Lassehoutenbos/KL-UAS-System/GCS/bottom_panel_developer_overview.docx

Ground Control Station

Bottom Panel — Developer Overview

Firmware Architecture, Hardware Connections & Peripheral Guide

# 1. System Overview

The bottom panel is a hardware input/output module for a ground control station. It collects analog sensor readings, digital switch states, and drives addressable RGB LEDs. All data is aggregated by a Raspberry Pi Pico W microcontroller and forwarded to a Raspberry Pi host computer over USB CDC (virtual serial port). The Pico W runs FreeRTOS, with each peripheral type managed by a dedicated task that feeds a shared queue consumed by the USB transmit task.

The Pico W was chosen for its native USB support, dual-core ARM Cortex-M0+ running at 133 MHz, hardware PIO state machines for precise LED timing, and built-in WiFi/Bluetooth for future OTA firmware updates.

# 2. Hardware Components

## 2.1 Microcontroller — Raspberry Pi Pico W

The central controller. All peripherals connect directly or indirectly to the Pico W.

Feature | Detail
Chip | RP2040 (dual-core ARM Cortex-M0+ @ 133 MHz)
Flash | 2 MB on-board QSPI flash
SRAM | 264 KB
USB | Native USB 1.1 Full Speed (12 Mbps) — CDC via TinyUSB
Wireless | CYW43439 — 2.4 GHz WiFi 802.11n + Bluetooth 5.2 (future OTA)
GPIO | 26 usable GPIO pins
ADC | 4 native 12-bit ADC channels (GP26–GP29)
PIO | 2 PIO blocks, 4 state machines each — used for LED protocols
I2C | 2 hardware I2C controllers
SPI | 2 hardware SPI controllers
Operating voltage | 3.3 V logic, 5 V USB input

## 2.2 GPIO Expander — U1 MCP23017

The MCP23017 is a 16-bit I2C GPIO expander providing additional digital I/O that the Pico W's native pins cannot accommodate. It handles all panel switches and indicator LEDs.

Pin | Connected To | Direction | Description
U1_A0 | LED2 | Output | Indicator LED 2
U1_A1 | LED3 | Output | Indicator LED 3
U1_A2 | LED4 | Output | Indicator LED 4
U1_A5 | KEY | Input | Key switch input
U1_A6 | SW3_3 | Input | Switch 3, contact 3
U1_A7 | SW3_4 | Input | Switch 3, contact 4
U1_B0 | SW1_1 | Input | Switch 1, contact 1
U1_B1 | SW1_2 | Input | Switch 1, contact 2
U1_B2 | SW1_3 | Input | Switch 1, contact 3
U1_B3 | SW2_1 | Input | Switch 2, contact 1
U1_B4 | SW2_2 | Input | Switch 2, contact 2
U1_B5 | SW2_3 | Input | Switch 2, contact 3
U1_B6 | SW3_1 | Input | Switch 3, contact 1
U1_B7 | SW3_2 | Input | Switch 3, contact 2

Connection to Pico W: I2C bus (SDA, SCL). Pull-up resistors required on SDA and SCL lines (4.7 kΩ to 3.3 V). I2C address set by hardware address pins A0–A2 on U1.

## 2.3 SPI ADC — MCP3208

The MCP3208 is an 8-channel 12-bit SPI ADC. It is used to expand the Pico W's 4 native ADC channels to cover all analog inputs on the bottom panel.

Channel | Signal | Description
CH0 | ADC0 BAT VIN | Battery voltage monitor
CH1 | ADC1 EXT VIN | External voltage input monitor
CH2 | SENS2 OUT | Sensor 2 analog output
CH3 | SENS3 OUT | Sensor 3 analog output
CH4 | SENS4 OUT | Sensor 4 analog output
CH5 | SENS5 OUT | Sensor 5 analog output
CH6 | (reserved) | Available for future use
CH7 | (reserved) | Available for future use

Connection to Pico W: SPI bus (SCK, MOSI, MISO, CS). Operates at 3.3 V. Reference voltage sets full-scale range — use 3.3 V VREF for direct compatibility with Pico W logic levels.

## 2.4 SK6812 Addressable LED Chain

The SK6812 addressable RGB LEDs form the primary LED chain on the bottom panel. They are driven by PIO state machine 0 at 800 Kbps using the SK6812 NRZ protocol.

Parameter | Value
Protocol | Single-wire NRZ at 800 Kbps
T0H / T0L | 0.3 µs / 0.9 µs
T1H / T1L | 0.6 µs / 0.6 µs
Reset pulse | > 80 µs low
Color depth | 24-bit RGB (8 bits per channel, GRB order)
Supply voltage | 5 V
Logic level | 5 V data line — requires level shifting from Pico W 3.3 V
Level shifter | U5 — 74LVC1T45DW-7 (3.3 V → 5 V, single direction)
PIO assignment | PIO block 0, state machine 0 (SM0)

## 2.5 WS2811 RGB Button Driver — LED5 & LED6

The two PB-26 RGB illuminated push buttons (LED5 and LED6) are driven by discrete WS2811 driver ICs. The WS2811 is a standalone 3-channel constant-current RGB LED driver in an SOP-8 package. Unlike the SK6812, the WS2811 exposes separate OUTR, OUTG, and OUTB pins which connect directly to the button's R, G, and B LED channels.

The WS2811 uses a different timing spec to the SK6812 (400 Kbps vs 800 Kbps) and therefore cannot share the same PIO data line. A separate PIO state machine is used.

Parameter | Value
Protocol | Single-wire NRZ at 400 Kbps
T0H / T0L | 0.5 µs / 2.0 µs
T1H / T1L | 1.2 µs / 1.3 µs
Reset pulse | > 50 µs low
Color depth | 24-bit RGB (8 bits per channel, RGB order)
Supply voltage | 5 V
Logic level | 5 V data line — requires level shifting from Pico W 3.3 V
Level shifter | Separate 74LVC1T45 (3.3 V → 5 V)
Package | SOP-8
Outputs | OUTR, OUTG, OUTB — connect directly to button LED R/G/B pins
PIO assignment | PIO block 0, state machine 1 (SM1)
Chain | LED5 WS2811 DIN → LED5 WS2811 DOUT → LED6 WS2811 DIN

## 2.6 RGB Buttons — PB-26 (LED5, LED6)

Signal | Wire Color | Connects To | Description
GND (Switch) | Black | GND | Ground for switch circuit
NO (Switch) | White | SW3– / MCP23017 | Normally open contact — read via U1
RGB +5V | Red | +5V rail | Power for RGB LED inside button
RGB R | Yellow | WS2811 OUTR | Red LED channel
RGB G | Green | WS2811 OUTG | Green LED channel
RGB B | Blue | WS2811 OUTB | Blue LED channel

# 3. Bus Connections

## 3.1 I2C Bus

One I2C bus shared between U1 (MCP23017). SDA and SCL lines run from the Pico W to U1. Pull-up resistors (4.7 kΩ) to 3.3 V are required on both lines. The MCP23017 hardware address (A0–A2 pins) must be set in firmware to match the PCB configuration.

Signal | Pico W Pin | Peripheral | Notes
SDA | GP4 (or GP8/GP12/GP16/GP20) | U1 MCP23017 SDA | 4.7 kΩ pull-up to 3.3 V
SCL | GP5 (or GP9/GP13/GP17/GP21) | U1 MCP23017 SCL | 4.7 kΩ pull-up to 3.3 V

## 3.2 SPI Bus

One SPI bus connecting the Pico W to the MCP3208 ADC. Standard 4-wire SPI: SCK, MOSI, MISO, and a dedicated chip select (CS) pin.

Signal | Pico W Pin | Peripheral | Notes
SCK | GP18 (SPI0 SCK) | MCP3208 CLK | SPI clock
MOSI | GP19 (SPI0 TX) | MCP3208 DIN | Data to ADC
MISO | GP16 (SPI0 RX) | MCP3208 DOUT | Data from ADC
CS | GP17 (GPIO) | MCP3208 /CS | Active low chip select

## 3.3 PIO — SK6812 LED Chain (SM0)

Signal | Pico W Pin | Peripheral | Notes
DATA | GP0 (PIO0 SM0) | 74LVC1T45 A pin | 3.3 V output to level shifter input
DATA (shifted) | 74LVC1T45 B pin | SK6812 chain DIN | 5 V shifted output to first LED

## 3.4 PIO — WS2811 Chain (SM1)

Signal | Pico W Pin | Peripheral | Notes
DATA | GP1 (PIO0 SM1) | 74LVC1T45 A pin | 3.3 V output to level shifter input
DATA (shifted) | 74LVC1T45 B pin | LED5 WS2811 DIN | 5 V shifted output
DOUT → DIN | WS2811 (LED5) DOUT | LED6 WS2811 DIN | Chain: LED5 output feeds LED6 input

## 3.5 USB CDC

The Pico W connects to the Raspberry Pi host via its native USB port. The TinyUSB stack running under FreeRTOS exposes a CDC class device. The Raspberry Pi sees the Pico W as /dev/ttyACM0 with no additional drivers required.

# 4. Firmware Architecture

## 4.1 RTOS

The firmware runs FreeRTOS on the RP2040. Each peripheral is managed by a dedicated FreeRTOS task. Tasks communicate via a shared FreeRTOS queue. The USB CDC transmit task is the sole consumer of this queue and serialises all data to the host.

## 4.2 Task Overview

Task | Priority | Period | Responsibility
ADC task | 2 | 10 ms | Reads MCP3208 over SPI. Samples all 6 active channels. Pushes readings to queue.
Digital I/O task | 2 | 20 ms | Reads U1 MCP23017 over I2C. Reports switch states and KEY input.
SK6812 LED task | 1 | On command | Receives LED color commands from queue or internal state. Writes to PIO SM0.
WS2811 LED task | 1 | On command | Controls LED5 and LED6 RGB buttons via PIO SM1 and WS2811 chain.
USB CDC task | 3 | 1 ms | Drains sensor data queue. Serialises to protocol packets. Writes to TinyUSB CDC.
TinyUSB task | 4 (highest) | 1 ms | Calls tud_task() — must run regularly to service USB hardware.

## 4.3 Data Flow

1. ADC task samples MCP3208 every 10 ms and pushes a structured sensor_data_t packet onto the FreeRTOS queue.

2. Digital I/O task polls the MCP23017 every 20 ms and pushes a digital_state_t packet onto the same queue.

3. USB CDC task wakes every 1 ms, drains the queue, serialises each packet using the binary protocol (see Section 5), and writes to the TinyUSB CDC TX buffer.

4. TinyUSB task flushes the CDC TX buffer to the USB hardware. On the host, the Raspberry Pi reads /dev/ttyACM0 using pyserial or equivalent.

5. LED tasks run independently. They receive color update commands from the USB CDC RX path (host → Pico W) or from internal logic, and update the LED chains via the respective PIO state machine.

## 4.4 PIO Programs

Two PIO programs are loaded at startup, one per state machine:

- sk6812.pio — loaded into PIO0 SM0. Implements 800 Kbps NRZ timing for the SK6812 LED chain. Reads 24-bit GRB pixel data from the TX FIFO and drives the DATA pin.
- ws2811.pio — loaded into PIO0 SM1. Implements 400 Kbps NRZ timing for the WS2811 chain driving LED5 and LED6. Reads 24-bit RGB pixel data from the TX FIFO.

Both PIO programs use DMA to transfer pixel buffers from SRAM to the PIO TX FIFO without CPU involvement, freeing the FreeRTOS scheduler for other tasks.

# 5. USB CDC Data Protocol

## 5.1 Packet Structure

All data over USB CDC uses a simple binary framing protocol. Each packet has a fixed header followed by a variable payload.

Byte(s) | Field | Value / Description
0 | Start byte | 0xAA — fixed frame delimiter
1 | Packet type | 0x01 = ADC data, 0x02 = Digital I/O, 0x03 = LED command (host → Pico)
2 | Payload length | Number of payload bytes that follow (0–255)
3..N | Payload | Type-specific data (see below)
N+1 | Checksum | XOR of all payload bytes

## 5.2 Packet Types

### Type 0x01 — ADC Data (Pico W → Raspberry Pi)

Offset | Field | Type | Description
0–1 | ch0_bat_vin | uint16_t | Battery voltage raw ADC count (0–4095)
2–3 | ch1_ext_vin | uint16_t | External voltage raw ADC count
4–5 | ch2_sens2 | uint16_t | Sensor 2 raw ADC count
6–7 | ch3_sens3 | uint16_t | Sensor 3 raw ADC count
8–9 | ch4_sens4 | uint16_t | Sensor 4 raw ADC count
10–11 | ch5_sens5 | uint16_t | Sensor 5 raw ADC count
12–13 | timestamp_ms | uint16_t | FreeRTOS tick count (ms) at sample time

### Type 0x02 — Digital I/O State (Pico W → Raspberry Pi)

Offset | Field | Type | Description
0 | port_a | uint8_t | MCP23017 port A state (bits 0–7 = A0–A7)
1 | port_b | uint8_t | MCP23017 port B state (bits 0–7 = B0–B7)
2–3 | timestamp_ms | uint16_t | FreeRTOS tick count (ms)

### Type 0x03 — LED Command (Raspberry Pi → Pico W)

Offset | Field | Type | Description
0 | chain | uint8_t | 0x00 = SK6812 chain, 0x01 = WS2811 chain (LED5+6)
1 | num_pixels | uint8_t | Number of pixels in this update
2..N | pixel_data | uint8_t[] | GRB bytes for SK6812, RGB bytes for WS2811. 3 bytes per pixel.

# 6. Source File Structure

File | Responsibility
src/main.c | FreeRTOS scheduler init. Creates all tasks. Initialises hardware (I2C, SPI, PIO, USB).
src/usb_cdc.c/h | TinyUSB CDC task. Packet serialisation/deserialisation. TX queue consumer.
src/protocol.c/h | Packet struct definitions. Serialise/deserialise helpers. Checksum.
src/analog.c/h | ADC task. MCP3208 SPI driver. Reads all 6 channels, pushes sensor_data_t to queue.
src/digital_io.c/h | Digital I/O task. MCP23017 I2C driver. Reads port A and B, pushes digital_state_t.
src/led_sk6812.c/h | SK6812 LED task. Manages pixel buffer. Triggers DMA transfer to PIO0 SM0.
src/led_ws2811.c/h | WS2811 LED task. Manages LED5 and LED6 pixel state. DMA to PIO0 SM1.
src/sk6812.pio | PIO assembly program for SK6812 — 800 Kbps NRZ timing.
src/ws2811.pio | PIO assembly program for WS2811 — 400 Kbps NRZ timing.
tusb_config.h | TinyUSB configuration. CDC class enabled. FreeRTOS mode.
FreeRTOSConfig.h | FreeRTOS kernel configuration. Heap size, tick rate, task priorities.
CMakeLists.txt | Build system. Links SDK, FreeRTOS, TinyUSB, PIO header generation.

# 7. Development Notes

- All GPIO pin numbers above are suggestions. Final pin assignment must be confirmed against the PCB layout and locked in a single header file (e.g. pins.h).
- The FreeRTOS heap is set to 192 KB. Monitor stack usage during development with uxTaskGetStackHighWaterMark().
- The WS2811 expects RGB byte order. The SK6812 expects GRB byte order. Ensure the correct order is used in each LED task's pixel buffer.
- The MCP23017 interrupt pins (INTA, INTB) are available but not used in the initial design. Consider enabling interrupt-driven I/O reading instead of polling to reduce I2C bus load.
- The CYW43439 WiFi chip shares the SPI bus with the RP2040 internally. The Pico W SDK manages this — do not use SPI1 pins that conflict with the wireless chip. Check the Pico W pinout before assigning SPI1.
- For OTA firmware updates, the pico_cyw43_arch_lwip_sys_freertos library is already linked in CMakeLists.txt. A future WiFi task can be added without restructuring the existing architecture.
- The 74LVC1T45 level shifters require the direction pin (DIR) to be tied to VCC or GND permanently for a single direction. Confirm direction pin wiring on the PCB matches firmware expectations.

Confidential — Internal Use OnlyPage

Ground Control Station — Bottom Panel Developer Overview
