Lassehoutenbos/KL-UAS-System/GCS/docs/Schematic_Flightcase_2026-04-02.png

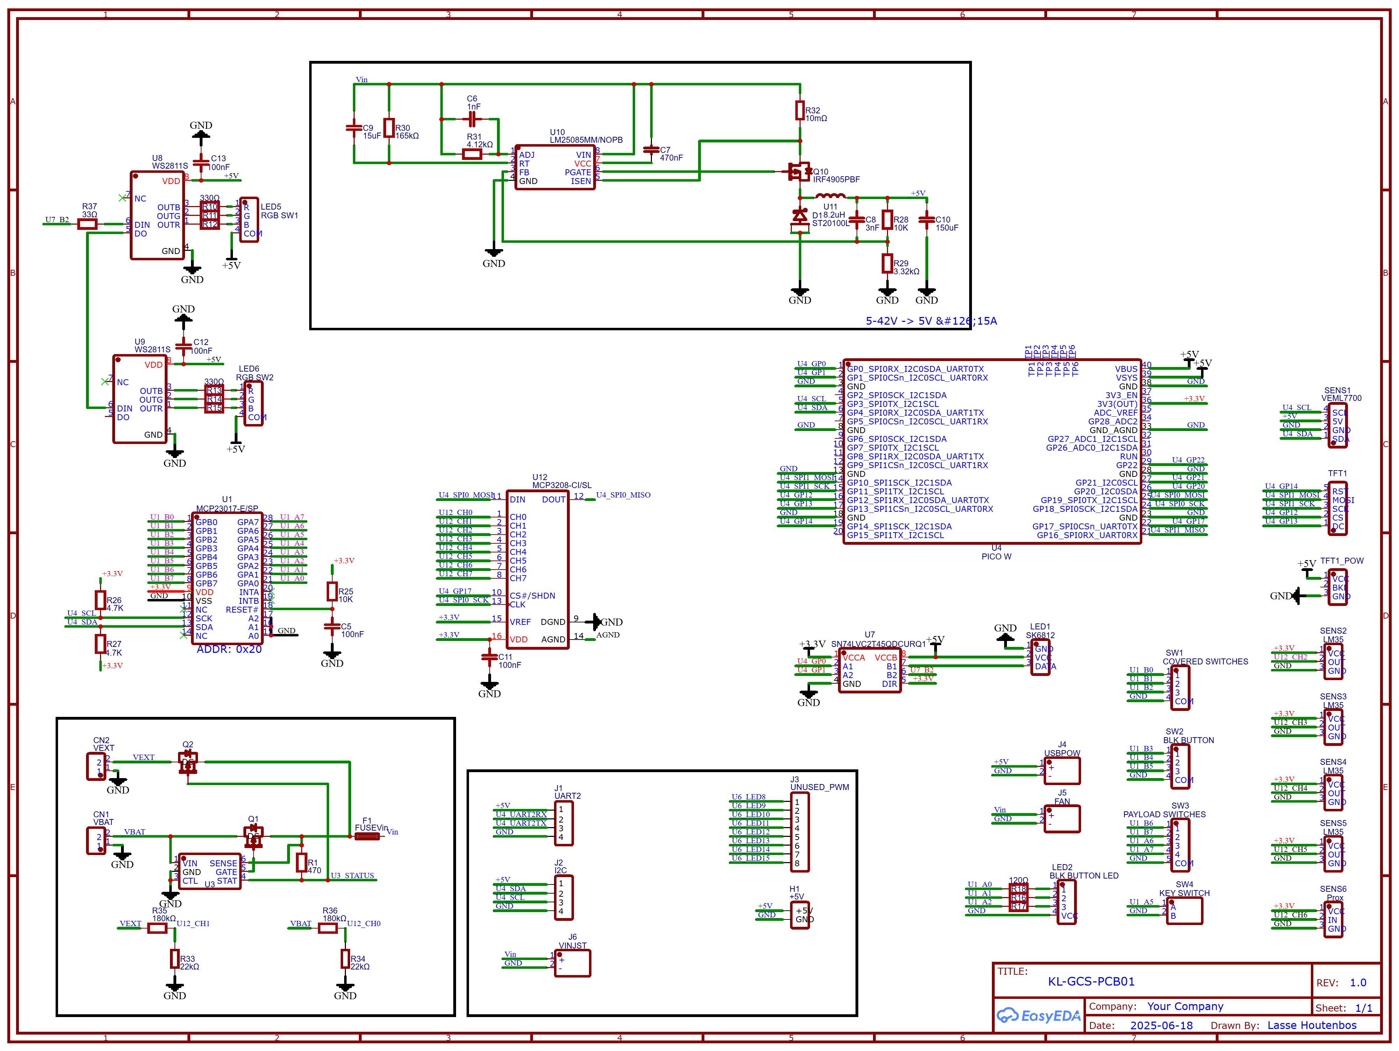
GCS/docs/Schematic_Flightcase_2026-04-02.png
