Lassehoutenbos/KL-UAS-System/KL-GCS-PICODE/PICODE/Schermafbeelding 2026-04-06 224630.png

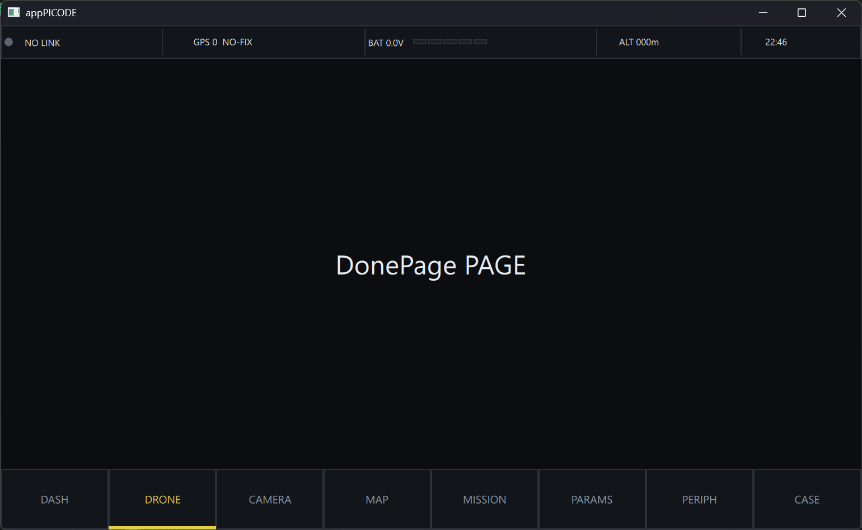
KL-GCS-PICODE/PICODE/Schermafbeelding 2026-04-06 224630.png
