Lassehoutenbos/KL-UAS-System/PCBCodeDocs/images.jpg

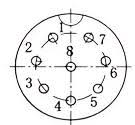
PCBCodeDocs/images.jpg
