Lassehoutenbos/KL-UAS-System/Sticker/Case v10.png

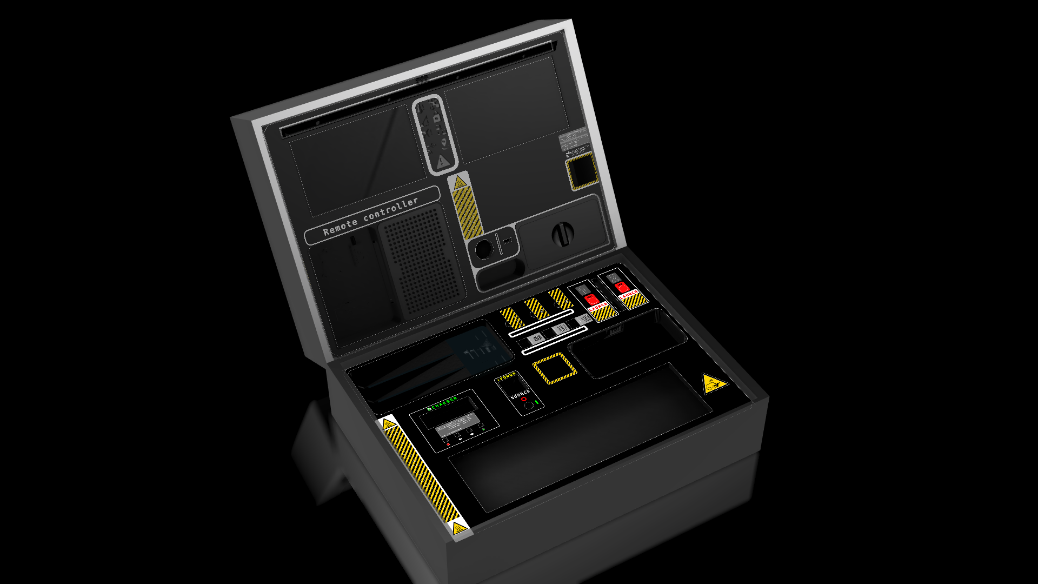
Sticker/Case v10.png
