Lassehoutenbos/KL-UAS-System/Sticker/Case_2026-Apr-13_04-44-15PM-000_CustomizedView62918959768_png_alpha.png

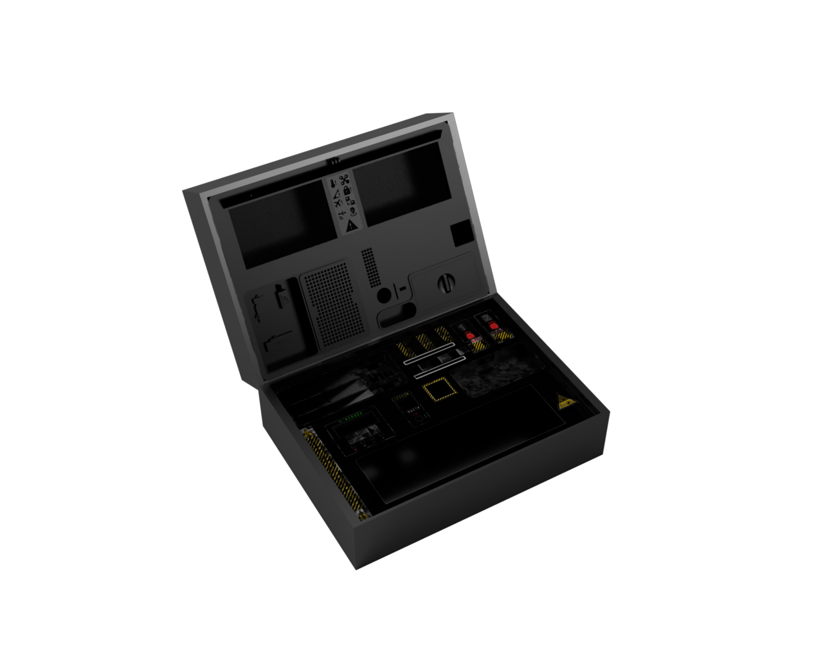
Sticker/Case_2026-Apr-13_04-44-15PM-000_CustomizedView62918959768_png_alpha.png
