Lassehoutenbos/KL-UAS-System/Sticker/Exports/bitmap.png

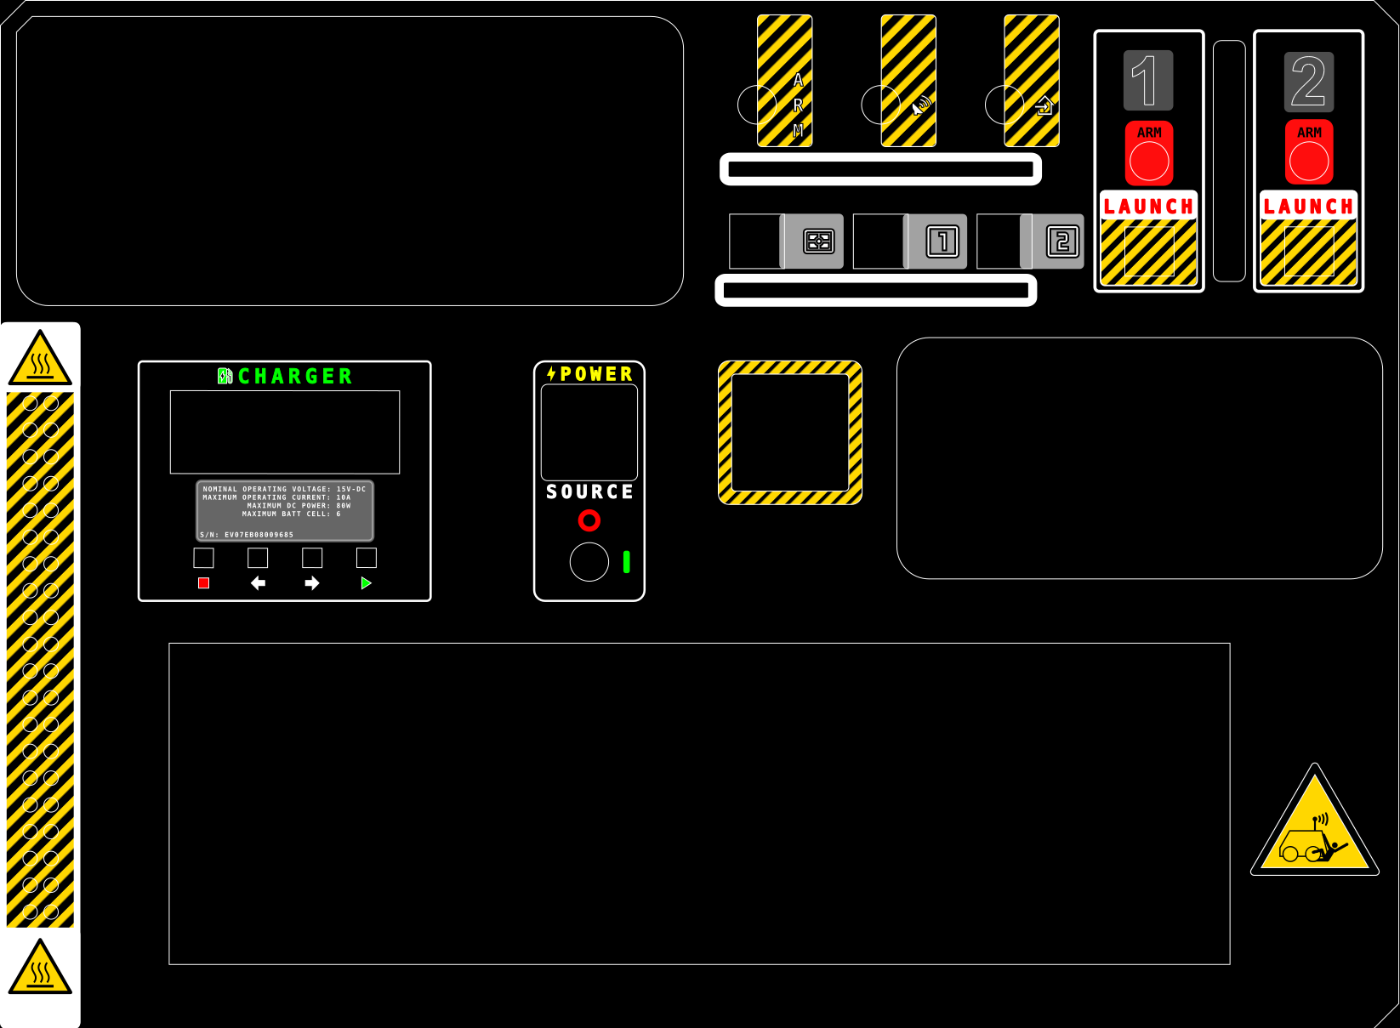
Sticker/Exports/bitmap.png
