Lassehoutenbos/KL-UAS-System/Sticker/Exports/forrender.png

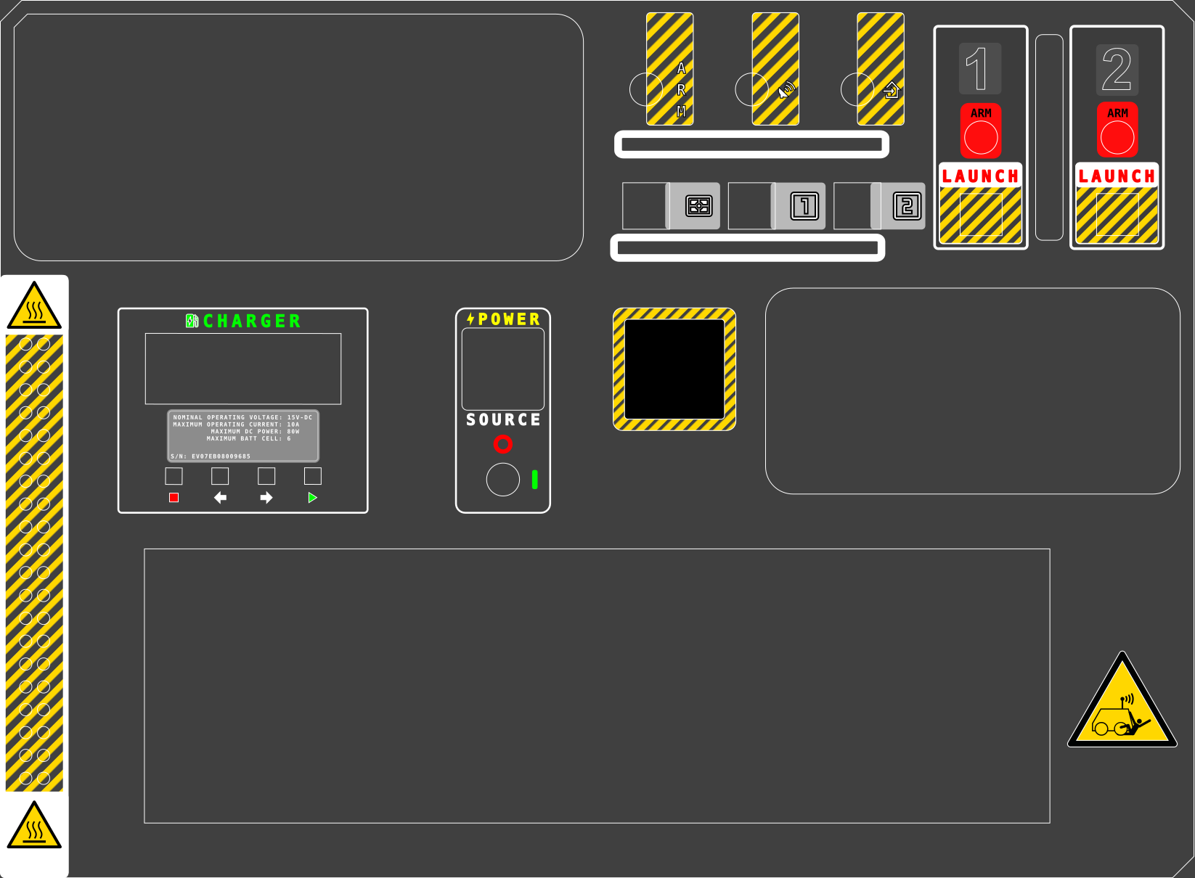
Sticker/Exports/forrender.png
