Lassehoutenbos/KL-UAS-System/Sticker/Exports/forrender_flipped.png

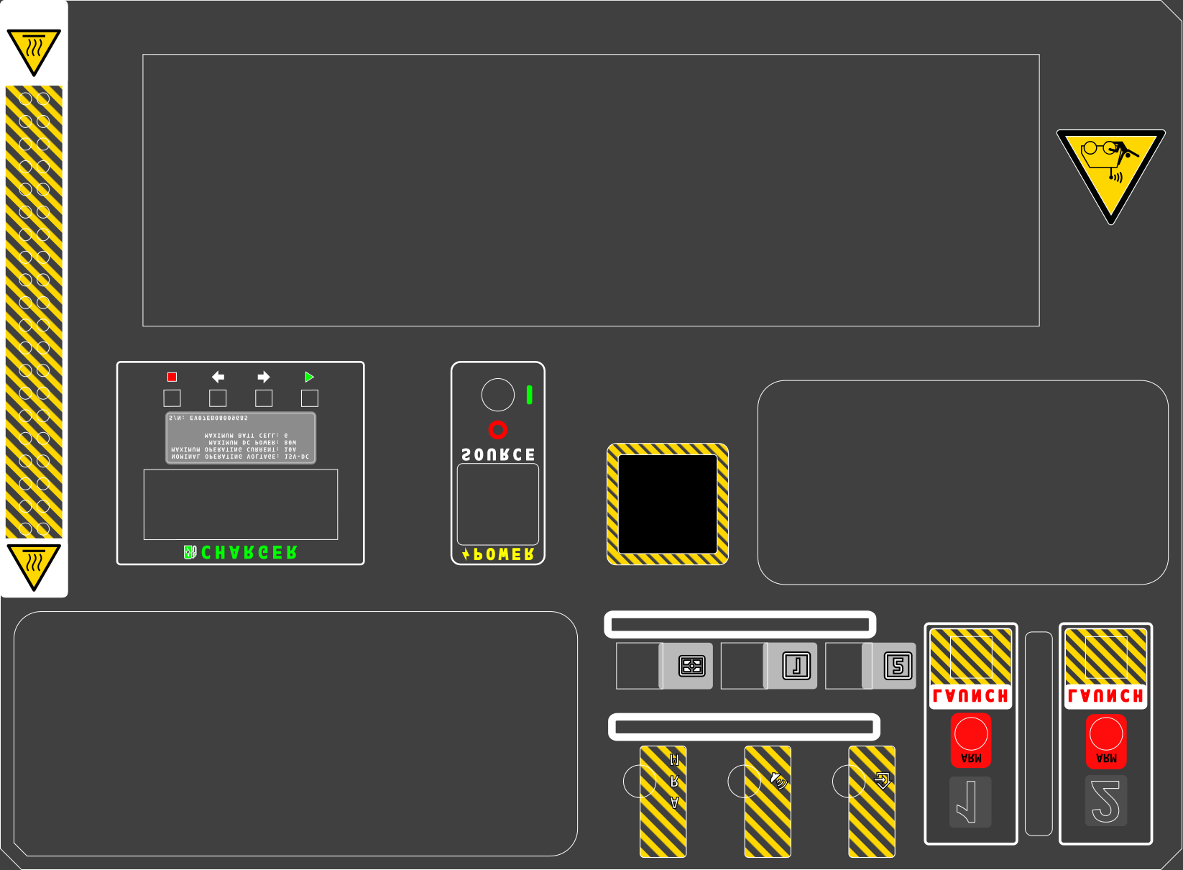
Sticker/Exports/forrender_flipped.png
