Lassehoutenbos/KL-UAS-System/Sticker/TopPanel.png

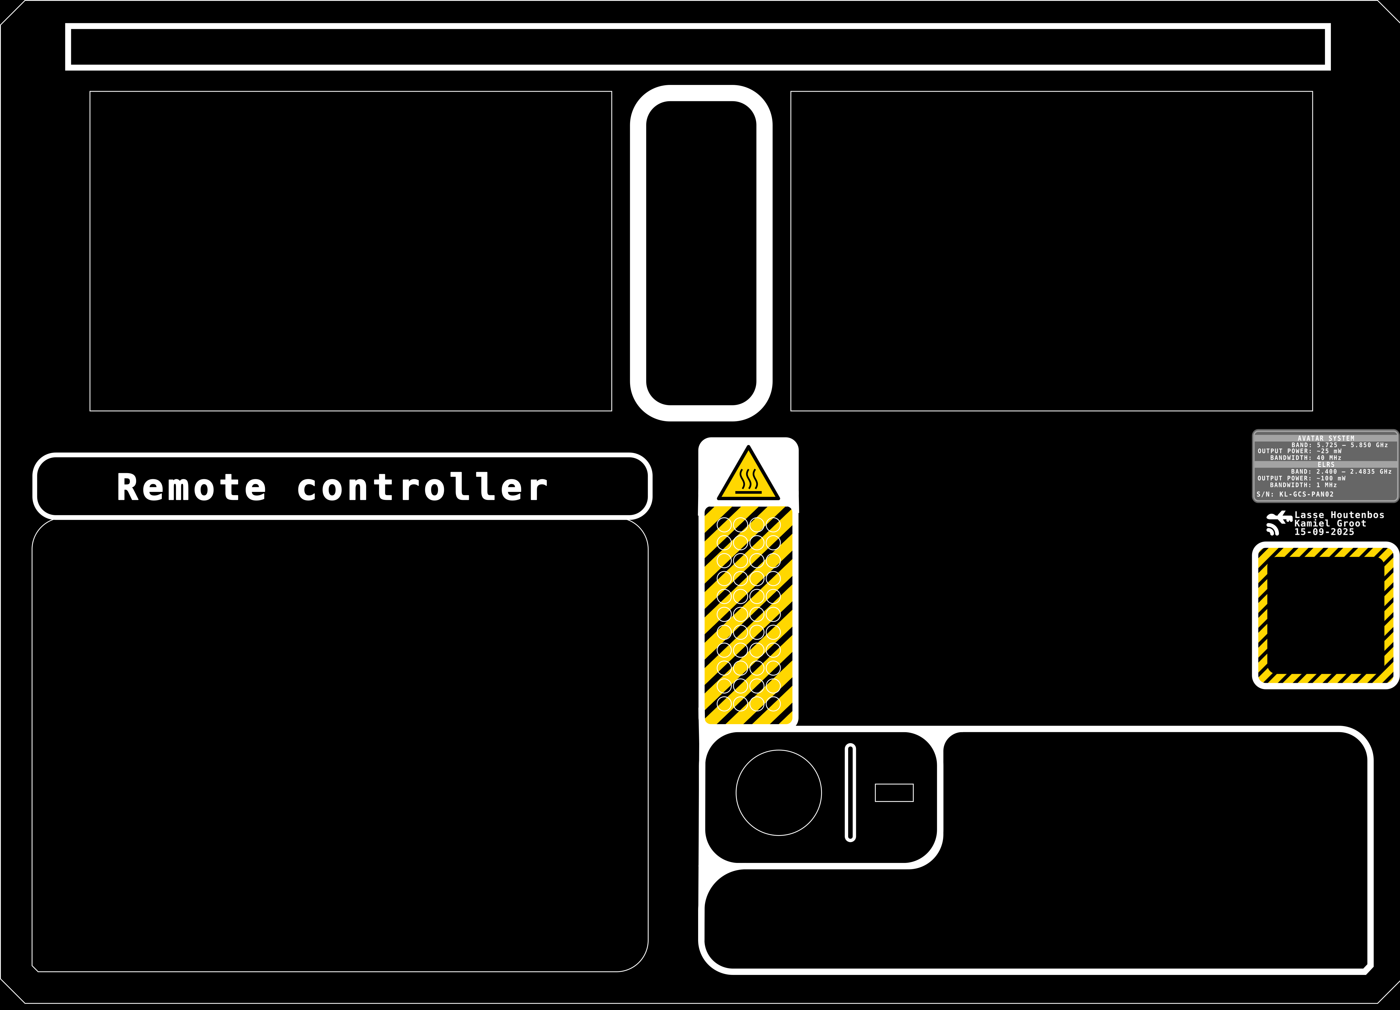
Sticker/TopPanel.png
