Lassehoutenbos/KL-UAS-System/3D files/Charger/Knopjes Charger v4.3mf

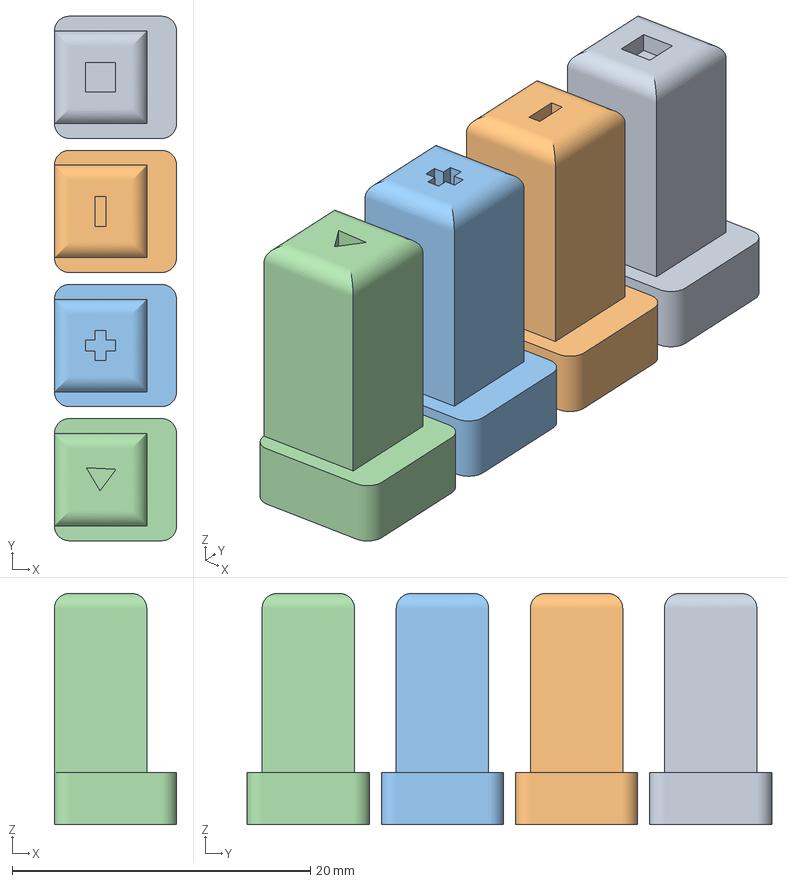
[picture p10: CAD file, 2025-10-26]
3D files/Charger/Knopjes Charger v4.3mf
8.20 x 35.2 x 15.5 mm
