Lassehoutenbos/KL-UAS-System/Sticker/Sketches/KL-GCS-PAN01.dxf

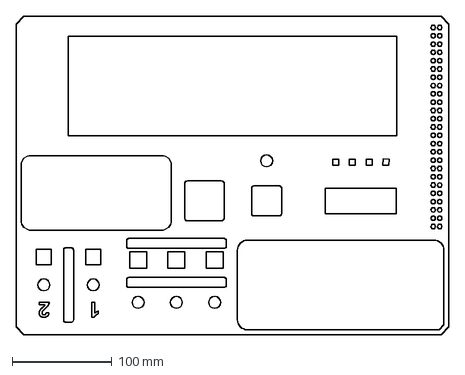
[picture p11: CAD file, 2025-07-04]
Sticker/Sketches/KL-GCS-PAN01.dxf
435.0 x 320.0 mm
