Lassehoutenbos/KL-UAS-System/Sticker/Sketches/Sketch15.dxf

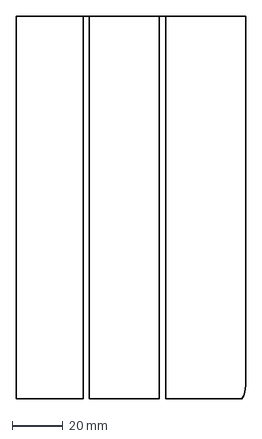
[picture p12: CAD file, 2025-06-27]
Sticker/Sketches/Sketch15.dxf
90.0 x 150.1 mm
