Lassehoutenbos/KL-UAS-System/Sticker/Sketches/Sketch13.dxf

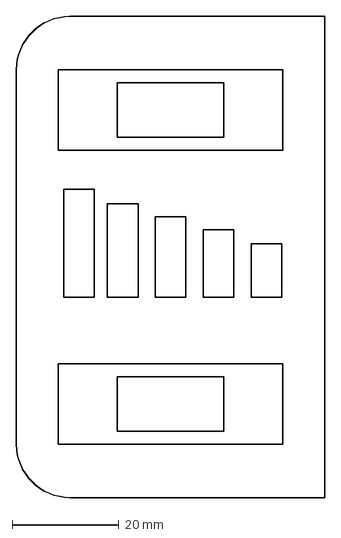
[picture p13: CAD file, 2025-06-27]
Sticker/Sketches/Sketch13.dxf
57.7 x 90.0 mm
