Lassehoutenbos/KL-UAS-System/3D files/Charger/Knopjes Charger v2.3mf

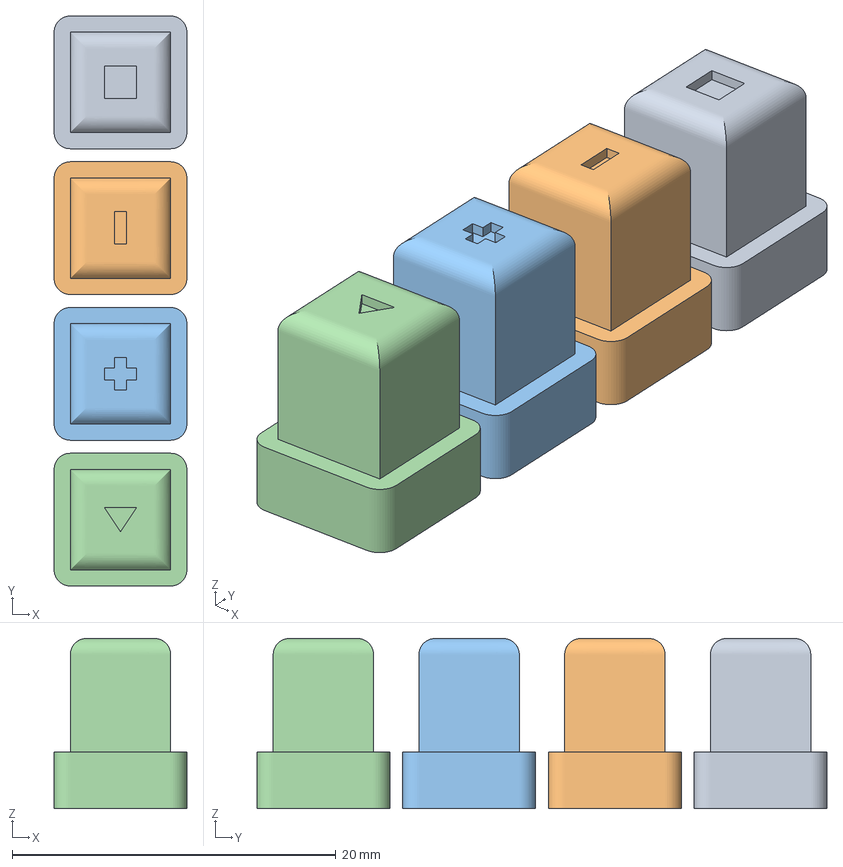
[picture p14: CAD file, 2025-07-04, an earlier design]
3D files/Charger/Knopjes Charger v2.3mf
8.20 x 35.2 x 10.5 mm
