Lassehoutenbos/KL-UAS-System/(threads)

Thread 2 (2025-07-10):

PCB design

Lassehoutenbos, 2025-07-10:
- [ ] Transistor for vibration motor
- [ ] Schematics for mini vib motors

Closed 2025-07-13.

Thread 25 (2025-08-31):

Add warning and status lights with captive touch

Lassehoutenbos, 2025-08-31:
### Warning and status light

To give the operator a heads up warning lights will be intergrated in the toppanel of the GCS.
To silence these warnings the operator should be able to push the led. There could be other actions when pressed other than just silencing the alarm.

Using black and translucent PETG we can 3D print this design for the most part. Using this videos as inspiration

- [ ] Design layout
- [ ] add captive touch capabilities
- [ ] Add lighting
- [ ] Add code

For lights the SK6812 leds are the best option, all driver code is already implemented.

Captive touch needs a wire. Best option is prob [MPR121 ](https://www.tinytronics.nl/nl/sensoren/touch/mpr121-capacitieve-touch-sensor-module)

Icons:
- Temp warning
- Drone notify/connect
- Connection warning
- Lock warning
- Aircraft warning
- Network notify
- GPS mode/notify/error
- Quad notify error/connect
- Global warning

Thread 28 (2025-09-05):

Power switching circuit

Lassehoutenbos, 2025-09-05:
The circuit which handles the uninterrupted switching from or to mains is not complete or inactive.

Thread 29 (2025-09-05):

Both fans need to be PWM controlled

Lassehoutenbos, 2025-09-05:
The PCB needs to be changed if the fans are PWM controlled. Speeds and working ranges are controlled by the temp sensor spreaded throughout the case.
