Lassehoutenbos/KL-UAS-System/Sticker/Exports/TopPanel.pdf

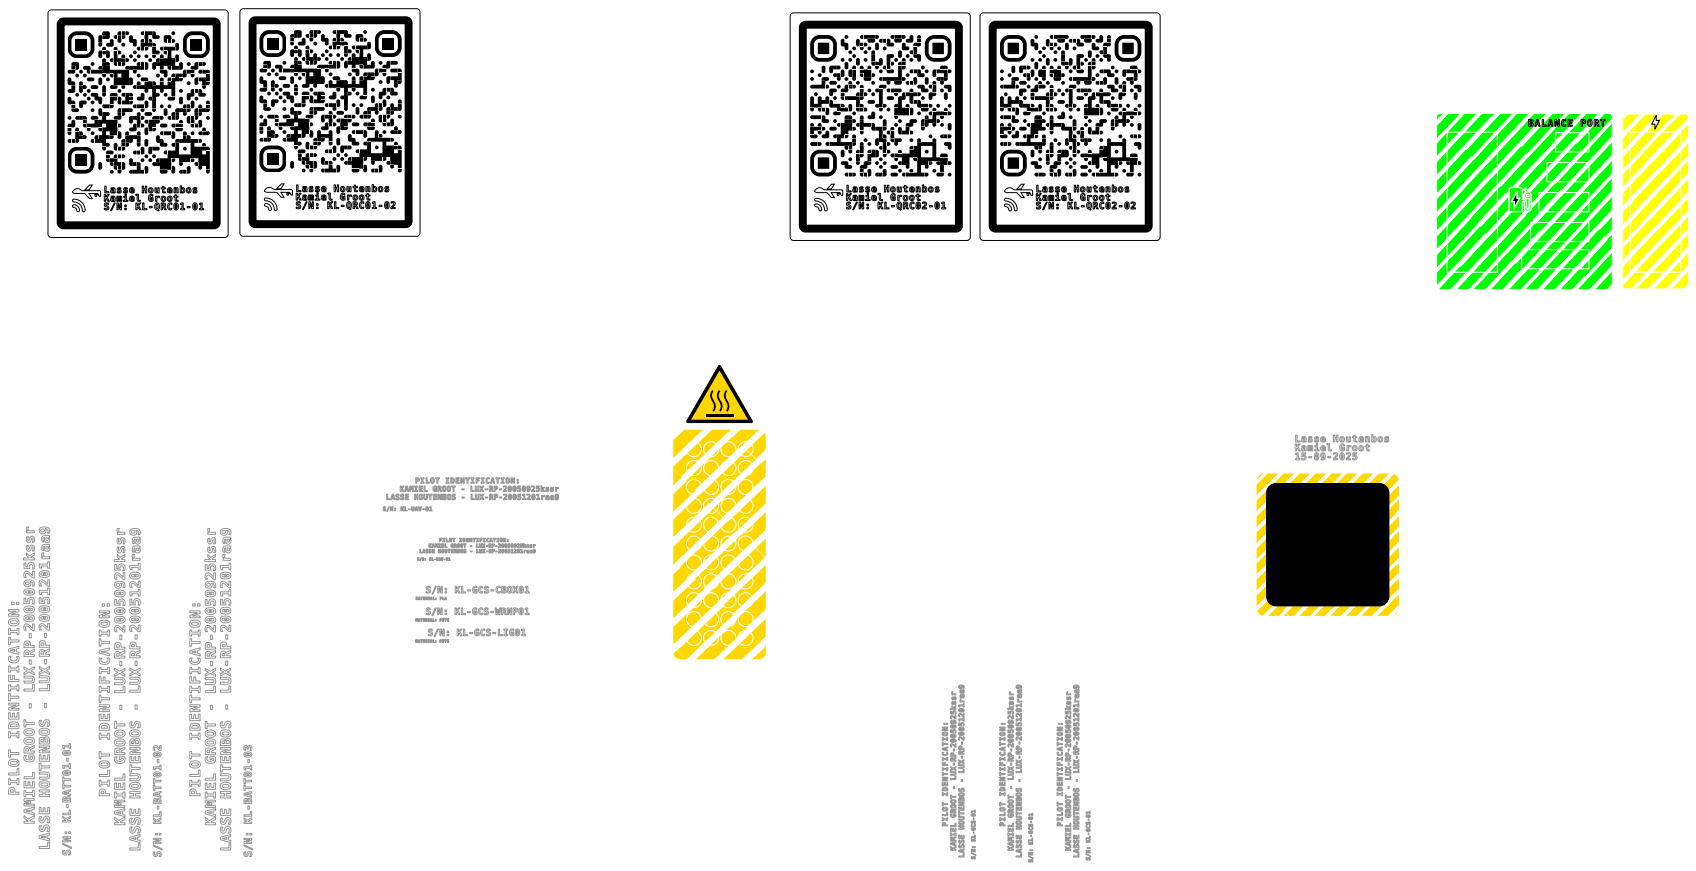
[picture p15: page 1]
PILOT IDENTIFICATION:; S/N: KL-BATT01-01; S/N: KL-BATT01-02; S/N: KL-BATT01-03; S/N: KL-GCS-01; BATTERY3; BATTERY2; BATTERY1

KAMIEL GROOT - LUX-RP-20050925kssr

LASSE HOUTENBOS - LUX-RP-20051201raa9
