Lassehoutenbos/KL-UAS-System/Sticker/Exports/ForPrint.pdf

A
R

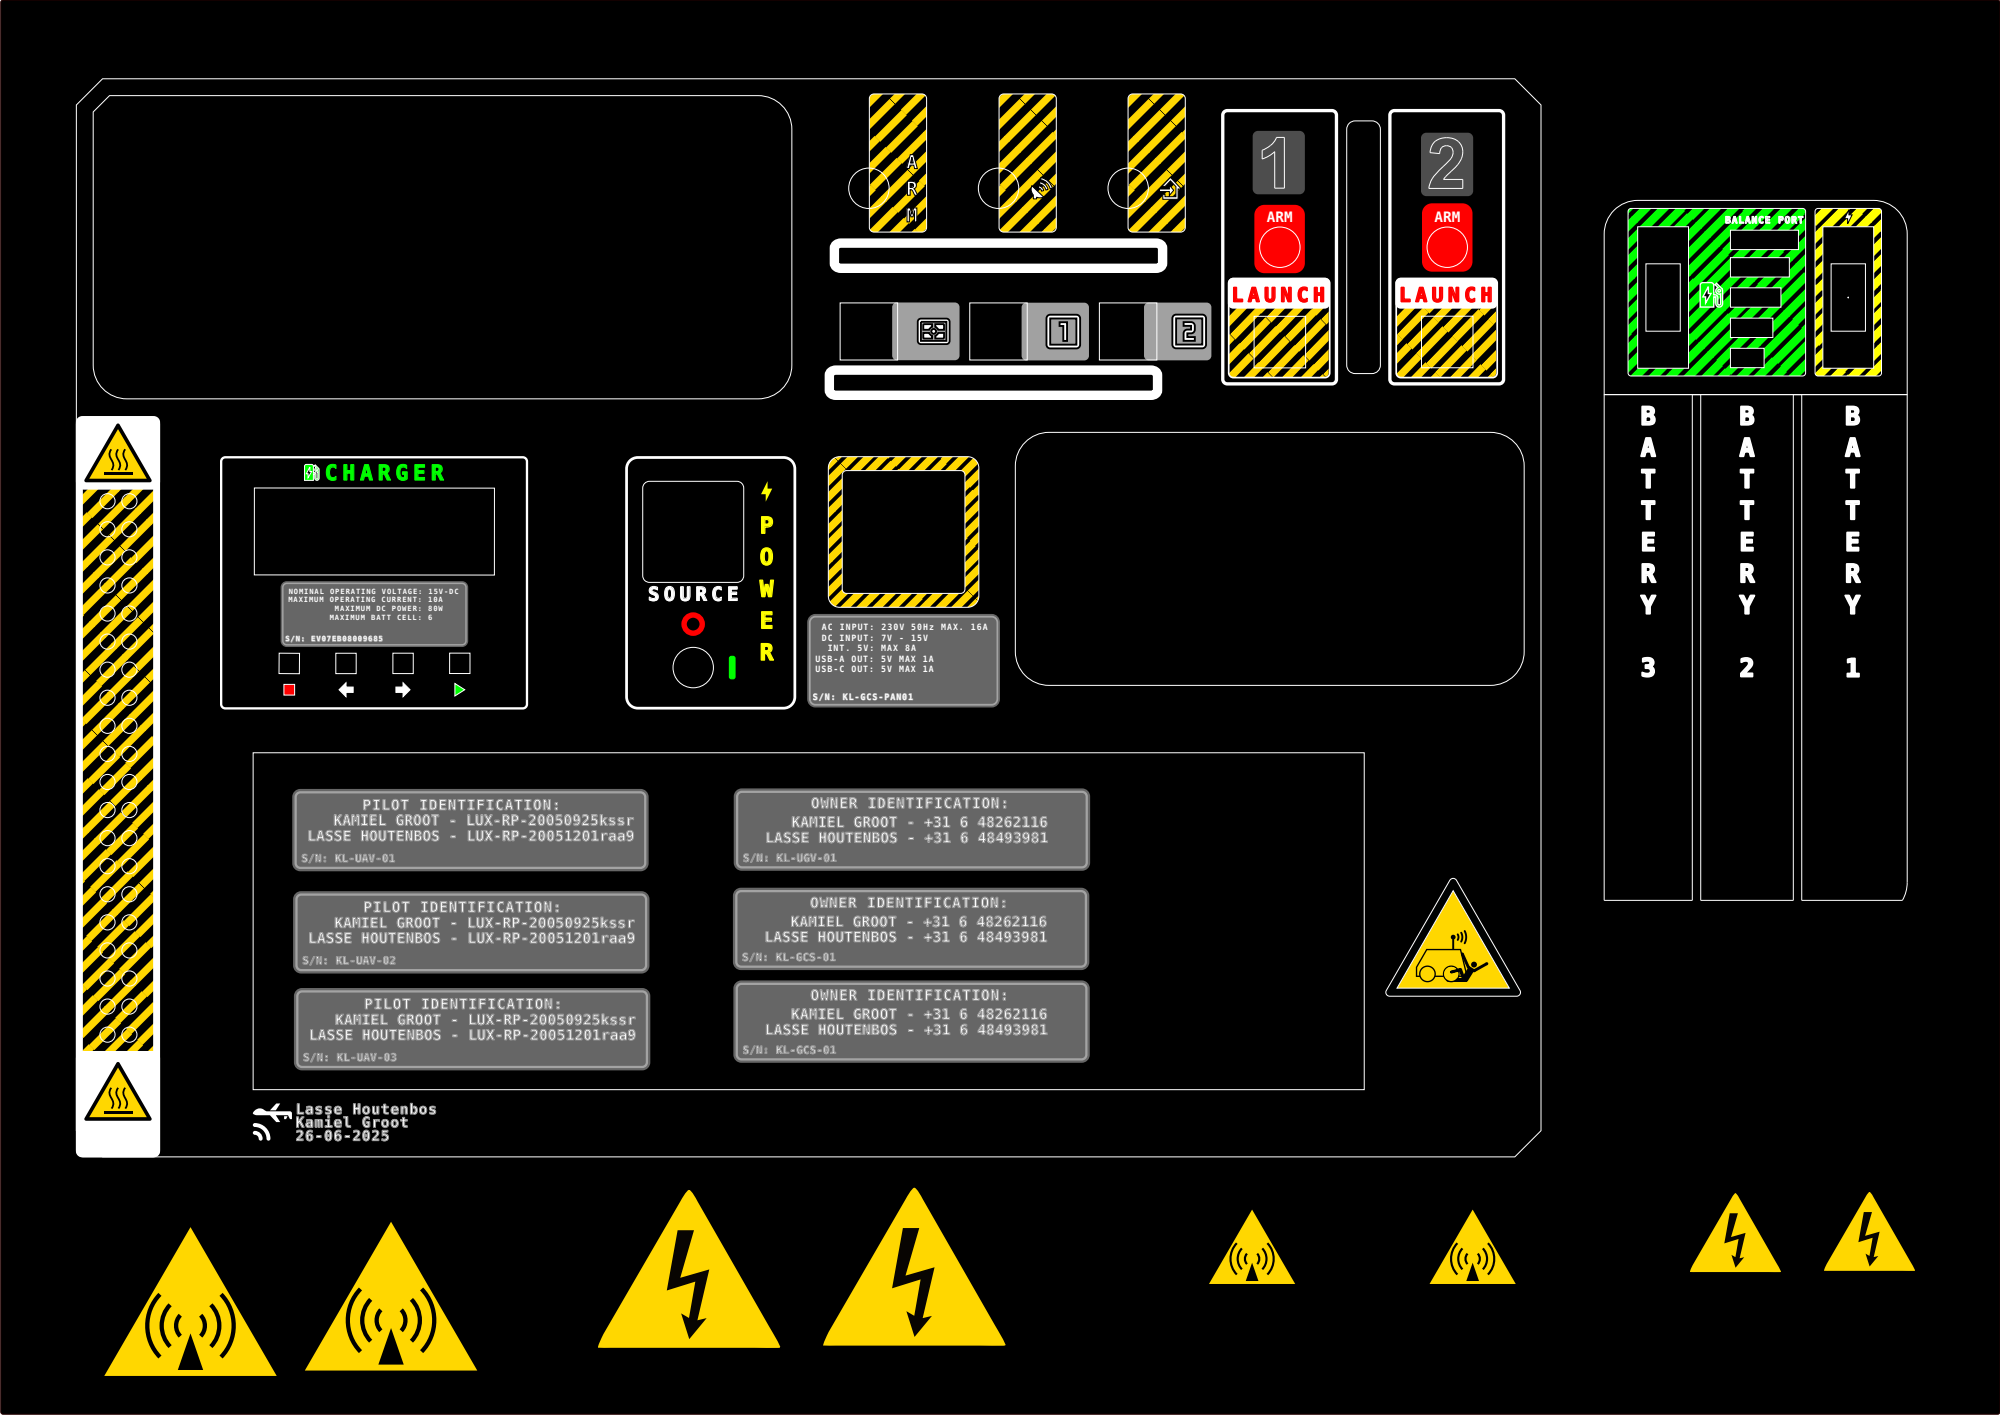
[picture p16: page 1]
S/N: KL-GCS-PAN01; Lasse Houtenbos Kamiel Groot 26-06-2025; LASSE; HOUTENBOS - LUX-RP-20051201raa9; S/N: KL-UAV-01; S/N: KL-UAV-02; KAMIEL GROOT -; LUX-RP-20050925kssr; S/N: KL-UAV-03; OWNER IDENTIFICATION: KAMIEL GROOT - +31 6 48262116; HOUTENBOS - +31 6 48493981; S/N: KL-UGV-01; S/N: KL-GCS-01; OWNER IDENTIFICATION: KAMIEL GROOT - +31 6 48262116 LASSE HOUTENBOS - +31 6 48493981; BALANCE PORT; ARM

PILOT IDENTIFICATION:
KAMIEL GROOT - LUX-RP-20050925kssr

LASSE HOUTENBOS - LUX-RP-20051201raa9
