Lassehoutenbos/KL-UAS-System/(list of files, drawings)

Other design files:
GCS/SCH_Flightcase_2026-04-02.json
