Lassehoutenbos/KL-UAS-System/Ground Control Station/BottomPanelCode/test/stubs/pins.h

#pragma once
#include <cstdint>

constexpr uint8_t PIN_SENS2 = 0;
constexpr uint8_t PIN_SENS3 = 1;
constexpr uint8_t PIN_SENS4 = 2;
constexpr uint8_t PIN_SENS5 = 3;

constexpr uint8_t FAN1_PWM_CH = 6;
constexpr uint8_t FAN2_PWM_CH = 7;

inline void setupPins() {}
