Lassehoutenbos/KL-UAS-System/(commit log)

2025-04-21 ✨Added folders
    📝Added calculations
    [ECS.step, Mejzlik Static thrust calculator_Version1.xlsx, Speedybee F7V3.step]
2025-04-21 🎉Added Readme
    Added all calculations
    Added datasheets
2025-04-21 Update Mejzlik Static thrust calculator_Version1.xlsx
    [Mejzlik Static thrust calculator_Version1.xlsx]
2025-05-23 🏗️ Added 3D Files
    Added following files:
    Cam-mounts
    Landing gear
    [ECS.step, GoPro-ZipTie-Mount3.stl, K400 Keyboard Tray.3mf, LandingGear.3mf, Speedybee F7V3.step, ziptie-gopro.stl]
2025-05-23 📝 Changed Docs
    Edited Facturen
    Added PDFs to facturen
    Added logs/video logs
    Added Calculations
    [Mejzlik Static thrust calculator_Version1.xlsx, Mejzlik_Propellers_Dynamic_Thrust_calculator_version 1.xlsm]
2025-05-23 ✨Added code
    ✨Added BLHeli software
    ✨Added python UI
    ✨Added python tracking script
    [BLHeli32DefaultsX.cfg, drone_3d_orientation_log.csv, drone_follow_log.csv, drone_path_log.csv]
2025-06-24 Added Sticker
    [INAV_8.0.1_cli_20250527_150549.txt]
2025-06-24 Add Arduino sketch for screen power switch demo
    Initial commit of ScreenPowerSwitch.ino, which demonstrates switching between battery and plug power sources on an ST7735 display. Includes animated switch arm, voltage simulation, and custom icons for battery and plug.
2025-06-27 Stickers Files
    Added a loads of icons
    [Sketch13.dxf, Sketch15.dxf]
2025-07-04 Initial commit
    Project scaffolding and initial file setup.
    [K400 Keyboard Tray.3mf, Knopjes Charger v2.3mf, Leg v2.step, PlaatBodem.dxf, Sketch13.dxf, Sketch15.dxf]
2025-07-10 Create Pinnen.md
    Added PCB pin connections list
2025-07-10 Add BottomPanelCode and clean up legacy software
    Added new PlatformIO-based BottomPanelCode project for the Ground Control Station, including initial source, headers, and configuration files. Removed legacy BLHeliSuite32 binaries, configs, and tracking/UI scripts to clean up the repository. Updated ScreenPowerSwitch.ino to use a configurable display rotation.
    [BLHeli32DefaultsX.cfg, drone_3d_orientation_log.csv, drone_follow_log.csv, drone_path_log.csv]
2025-07-12 Refactor codebase to modular lib structure
    Moved implementation files from 'include' to 'lib' directories, modularizing code into Blinker, SwitchHandler, Switches, leds, and pins libraries. Updated include paths, expanded LED and switch handling, and improved pin definitions. Enhanced platformio.ini with debug environment and additional dependencies. Main application now initializes and updates switches using the new structure.
2025-07-12 Switch to Adafruit NeoPixel for STM32F411
2025-07-12 Add debug environments and update switch HID behavior
    Renamed the debug HID environment in platformio.ini and added a new debug LED environment. Modified Switches.cpp to send a string via BootKeyboard in DEBUG_HID mode instead of a keypress. Updated main.cpp to call startup() in the main loop when DEBUG_LED is defined.
2025-07-12 Add Arduino code for screen power switch demo
    Introduces ScreenPowerSwitch.ino, an Arduino sketch that simulates switching between battery and plug power sources on an ST7735 display. Includes animated switch arm, voltage simulation, and custom icons for battery and plug.
2025-07-13 Add lock and confirmation logic to switch handling
    Introduced global lock (isLocked) and confirmation (isConfirmed) states to control switch and LED behavior. Switch actions and LED updates are now only allowed when the case is unlocked and switches are confirmed safe. Updated main loop to display lock, warning, or main screens based on these states for improved safety and user feedback.
2025-07-13 Update lock icon bitmap and debug display logic
    Replaces the lock icon bitmap with a larger 128x128 version and updates its drawing coordinates. Modifies main loop logic to always show the lock screen in DEBUG_LED mode and adjusts conditional compilation for debug startup.
    [main.cpp]
2025-07-13 Update pin assignments and add sensor inputs
    Refactored pin definitions to add SENS2-SENS5 analog inputs and updated their assignments in both code and documentation. Conditionalized BAT_VIN and EXT_VIN pin setup for DEBUG_HID. Updated GPIO output assignments and removed unused pin definitions.
2025-07-13 Add TempSensors class for LM35 sensors
2025-07-13 Remove unused analog sensor pin setup and add TempSensors
    Eliminated initialization of unused analog sensor pins (PIN_SENS2-5) in setupPins(). Integrated TempSensors library and initialization in main.cpp to support temperature sensor functionality.
2025-07-13 Integrate PWM fan control via PCA9685
2025-07-13 Update comments for unused LED mappings
    Changed comments for two unused LED mappings from 'DAC RGB' to 'PWM RGB' in leds.cpp to accurately reflect their intended function.
2025-07-13 Extend fan mapping to multiple sensors
2025-07-13 Fix debug key logic
    [main.cpp]
2025-07-14 Improve switchPositionAlert animation
2025-07-14 Refactor switch handling and debug modes in panel code
    Reworks switch initialization and state handling to better support DEBUG_HID and DEBUG_SCREENTEST modes, including new logic for key and switch pins. Adds allOffValue for LEDs, updates pin setup for debug modes, and ensures correct LED and confirmation behavior. Also adjusts random seed initialization and main loop structure for improved debug and normal operation.
    [main.cpp]
2025-07-17 Update Ground Control Station/BottomPanelCode/lib/Switches/Switches.cpp
2025-07-21 Add payload arm logic and update LED mappings
    Introduced armPayload1 and armPayload2 state variables to control payload arming logic. Modified switch 8 behavior to only activate if payload 1 is armed, and updated LED mappings for switches 6-9. Added a failSafe function to set LEDs to red for certain switches, and made minor formatting adjustments in main.cpp.
    [main.cpp]
2025-07-31 Updated SPI Clockspeed
2025-09-05 Add GCS technical docs, button mapping, and top panel SVG
    Added comprehensive documentation for Ground Control Station button mapping and bottom panel components, including system architecture, safety features, hardware integration, and software structure. Also added the TopPanel SVG for sticker design and updated README.md.
2025-09-05 Move GCS button mapping documentation to subfolder
    Relocated GCS_Button_Mapping.md from the project root to the 'Ground Control Station' directory for improved organization. No content changes were made to the documentation.
2025-09-07 Add Qt6 ground control station application
2025-09-07 Add documentation and update TopPanel.svg layout
    Added GCS_Button_Mapping.md and GCS_Docs.md for documentation. Updated TopPanel.svg with new dimensions, additional layers, and battery identification graphics. Added initial files for LedWarningTest and WarningPanelTest Arduino projects.
2025-09-07 Move application to new App directory and simplify codebase
    The application has been relocated from the 'application' directory to 'Ground Control Station/App', with a new minimal Qt Widgets implementation. Old code supporting serial and HID functionality was removed, and a new basic QMainWindow-based structure was added, including updated CMake configuration and UI files.
2025-09-07 Integrate RTOS-friendly WarningPanel library
    Added new WarningPanel library with thread-safe, RTOS-compatible warning and worklight LED control, including binary communication protocol and serial command interface. Updated main code to use shared LED strip, mapped warning/worklight LEDs to specific indices, and ensured coexistence with existing switch LED system. Documentation and usage examples provided for integration and testing.
2025-09-11 Update icon paths in button mapping documentation
    Changed image source paths in Ground Control Station/GCS_Button_Mapping.md to use relative Sticker/Icons directory instead of nested Ground Control Station path. Added a link to the button mapping documentation in README.md for easier access. Removed the obsolete GCS_Button_Mapping.md from the root directory.
2025-09-11 Add custom color filters to button icon images
    Applied inline CSS filter styles to all button and warning icon images in GCS_Button_Mapping.md for improved visual distinction and clarity. Updated README.md link text from 'Button descriptions' to 'Switches' for consistency with the documentation.
2025-09-18 Add new sticker SVG and update TopPanel.svg
    Added KL-QRC01-01_02.svg to the Sticker directory and made modifications to TopPanel.svg. These changes introduce a new sticker design and update the top panel artwork for the Ground Control Station.
2025-10-02 Enhance landing page with navigation and new sections
2025-10-02 Rename and update sticker panel files
    Renamed DXF and SVG files for sticker panels to new naming convention (KL-GCS-PAN01, KL-GCS-PAN02). Added TopPanel exports in PDF and PNG formats. Updated TopPanel SVG with new dimensions, export settings, and minor SVG property changes.
    [KL-GCS-PAN01.dxf]
2025-10-02 📝Cleaned up docs for GCS
    Edited file structure in GCS folder
2025-10-02 Add GCS button mapping documentation
    Introduces a comprehensive markdown document detailing the button and switch mapping for the Ground Control Station (GCS) bottom panel, including pin assignments, HID commands, safety features, LED behaviors, and payload control logic. This documentation supports integration and safe operation with the Raspberry Pi and outlines failsafe mechanisms.
2025-10-12 Add wiring documentation for PB-26 RGB buttons
2025-10-26 Remove App directory and add 3D charger file
    Deleted the entire Ground Control Station/App directory including source, build, and documentation files. Added a new 3D model file 'Knopjes Charger v4.3mf'. Updated, moved, and modified several files in BottomPanelCode and Sticker directories.
    [KL-GCS-PAN01.dxf, Knopjes Charger v4.3mf]
2025-11-01 Fix FreeRTOS blocking delays and remove duplicate code
    [main.cpp]
2026-03-28 Add GCS firmware, test code, and 3D battery models
    Add the Ground Control Station (GCS) firmware and development files: CMake/PlatformIO configs, FreeRTOSConfig, Pico SDK import, VS Code settings, USB/CDC, protocol, display drivers (ST7735), LED PIO drivers, system state, pins, and related headers/sources. Include testcode and Python utilities (parser, protocol, serial_driver, test_protocol) and move/rename the ScreenPowerSwitch example. Add 3D assets for the Battery Quick Release (.3mf, .obj) and PCB/technical documents and other GCS resources. Remove an outdated GCS_Technical_Docs_Rev2.md and add supporting documentation and developer overview files.
    [Battery-Quick-Release.3mf]
2026-03-29 Add warning-panel protocol, LED handling, docs
    Implement Pi→Pico warning panel support and related UI/docs changes.
    - Add PROTO_TYPE_WARNING, warning icon indices, severities and warning_cmd_t in protocol.h and handle incoming warning packets in protocol.c (updates SK6812 state and notifies LED task).
    - Extend LED driver (led_sk6812): add volatile warning state, color/blink logic, led_sk6812_set_warning_state API, always include warning panel pixels in DMA buffer, and wake/update the panel every 50 ms for blink animation. Apply brightness per-channel.
    - Update led_sk6812.h API and task documentation accordingly.
    - Reduce ST7735 SPI default baud to 4 MHz in pins.h (avoid white-screen issue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
    [gcs_tester.py, led_sk6812.c, led_sk6812.h, pins.h, protocol.c, protocol.h, screen_display.c]
2026-03-29 Add VEML7700 ambient light sensor support
    Introduce VEML7700 ALS driver and UI/protocol support.
    - Add veml7700.c/.h: I2C driver, init (configures gain/IT), FreeRTOS task that reads ALS/WHITE registers every 500 ms, converts to millilux, updates shared g_latest_als and enqueues PROTO_TYPE_ALS (0x0B) packets on g_tx_queue.
    - Add PROTO_TYPE_ALS and als_packet_t to protocol.h (10-byte ALS packet: als_raw, white_raw, lux_milli, ts_ms).
    - Add VEML7700_ADDR (0x10) to pins.h.
    - Include veml7700.c in CMakeLists and call veml7700_init() / create veml7700_task() from main.c.
    - Update PCB_DESIGN.md with wiring, package notes, I2C address, and documentation about ALS packet/type and USB/TinyUSB details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
2026-03-29 Migration
    Moved all KL-UAV01 files to diff repo
    Added 3d files part
    Added deprecated
    [Battery-Quick-Release.3mf, ECS.step, GoPro-ZipTie-Mount3.stl, INAV_8.0.1_cli_20250527_150549.txt, Knopjes Charger v2.3mf, Knopjes Charger v4.3mf, LandingGear.3mf, Leg v2.step]
2026-03-29 Flatten Ground Control Station dir structure
    Move files and assets out of the Ground Control Station/ folder into top-level directories (GCS, Deprecated/[OLD] STM32Blackpill, 3D files, Sticker, PCBCodeDocs, Testcode). All changes are pure renames (similarity index 100%), reorganizing repository layout to group GCS source, sticker assets, 3D models and legacy code at the root level.
    [KL-GCS-PAN01.dxf, Knopjes Charger v2.3mf, Knopjes Charger v4.3mf, Sketch13.dxf, Sketch15.dxf]
2026-03-31 Split SPI buses, remove SPI mutex; add TFT self-test
    Refactor SPI usage so MCP3208 ADC uses SPI0 and ST7735 display uses SPI1, removing the shared g_spi1_mutex and simplifying drivers. Key changes:
    - Move MCP3208 defines to SPI0 (pins GP16-19) and initialize SPI0 in analog.c; remove g_spi1_mutex and associated semaphore usage/creation.
    - Make ST7735 use a dedicated SPI1 (pins GP10-GP14), initialize SPI1 in st7735_init(), update MADCTL/rotation, X/Y offsets, and increase ST7735 SPI baudrate. Remove semaphore take/give around display transfers.
    - Add redraw optimization in screen_display.c to only refresh main screen when data changes.
    - Update headers/docs to reflect new initialization order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
2026-03-31 Support SK6812 GRBW + SPI wiring updates
    Add support for 4-byte SK6812 (GRBW) pixels and update SPI pinning/docs to match hardware changes.
    - LED driver: change pixel buffer packing to include W channel, apply brightness to GRBW, and mark W=0 for warning colors.
    - Header: update led_sk6812 API doc to expect num_pixels*4 bytes (GRBW).
    - Protocol: accept SK6812 payloads as [chain][num_pixels][G R B W ...] and validate data_len against num_pixels*4.
    - Tester GUI: adjust max pixels per send from 84→63 (256-byte payload limit with 4 bytes/pixel), add W slider, include W in payloads/clears, and approximate preview by blending white additively.
    - PCB docs: reassign MCP3208 ADC to SPI0 (GP16–GP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
2026-03-31 Increase ADC divider to ~8:1 and restyle UI
    Update PCB docs and firmware to use an ~8:1 voltage divider (33 kΩ / 4.7 kΩ) so CH0/CH1 support up to ~25.2 V (6S LiPo). Adjust docs (PCB_DESIGN.md) to reflect new resistor values, ratio, max input and firmware conversion. Propagate the change to firmware (screen_display.c): set BAT_DIVIDER and EXT_DIVIDER to 8.021, update ADC-to-volts conversion usage, revise battery thresholds and charge-bar scaling for the 6S range, and overhaul the ST7735 UI artwork — new colour constants, headers/footers, accents, progress dots, refined battery/external/lock/warning screens and other layout tweaks. Also add a local .claude grep permission line to settings.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
2026-04-03 Add Flightcase schematic and update GCS code
    Add Flightcase schematic (JSON + PNG/SVG) and supporting docs, plus assorted GCS code updates. New files: GCS/SCH_Flightcase_2026-04-02.json, schematic PNG/SVG, RS485_PERIPHERAL_BUS.md and temporary tmpclaude placeholders. Docs: update GCS/docs/PCB_DESIGN.md. Firmware: modify GCS/src/pins.h, protocol.c/.h, screen_display.c, screen_st7735.c/.h to support the updated hardware/display/protocol needs. Update test harness: Testcode/gcs_tester.py adjusted accordingly.
    [SCH_Flightcase_2026-04-02.json]
2026-04-03 Docs: RS-485 bus — 3.3V bias and firmware spec
    Update RS-485 peripheral bus docs: change pull-up from 5V to 3.3V for the A bias resistor and update wording to place the bias resistors near the SP3485. Add a detailed firmware integration proposal describing new pin definitions, CDC packet types and payload structs, protocol handling changes, and a new RS-485 driver (rs485.h/.c) with task/queue, TX/RX frame handling and CRC. Also documents adding rs485_init()/rs485_task() to main and registering rs485.c in build sources, plus a summary table of the file-level changes.
2026-04-03 Document RS-485 transceiver and rear bus
    Add SP3485 RS-485 transceiver to PCB design docs and update pin mappings for UART1 and control signals (GP2 DE/RE, GP6 /INT, GP8 TX, GP9 RX). Include rear peripheral GX16-8 bus entry referencing the RS-485 peripheral bus doc, and clarify GP6 as open-drain with 10 kΩ pull-up. Update RS485_PERIPHERAL_BUS.md to note GP6 /INT wiring and behavior.
2026-04-13 Add RS-485 peripheral screens, PI docs, PICODE UI
    Introduce RS-485 peripheral bus support and peripheral overview/detail screens on the ST7735 display, plus companion Pi-side hardware docs and a new PICODE Qt/QML UI.
    Key changes:
    - Build: CMake updated to include src/rs485.c and link hardware_uart/hardware_pwm.
    - New RS-485 module: add GCS/src/rs485.c and rs485.h, pins for UART1 in pins.h, rs485 init/task started from main.c.
    - Protocol: add packet types 0x0C–0x0F (PERIPH_CMD/DATA/STATE/SCREEN) in protocol.h and handle forwarding / screen-select in protocol.c.
    - Display: extend screen_display API and implementation to support SCREEN_MODE_PERIPH and SCREEN_MODE_PERIPH_DETAIL, with cached p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
2026-04-13 Add worklight control and Quick Panel UI
    Introduce worklight state and color support in GCSState (properties, signals, invokable setters, and POI list) and emit cmdWorklightChanged for hardware control. Implement PicoLink handling to drive SK6812 worklight LEDs. Revamp QuickPanel and CasePage UIs: add lighting controls (worklight toggle, color swatches), master brightness slider with proportional scaling, quick layout chips, improved layout cards, and aligned SliderRow label/value widths. Add a new CaseView component (rendered case visualization) and include it in CMake; add TopPanel.png and an UPDATES.md documenting UI/hardware changes. Also update local settings to run a cmake build comman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
2026-04-15 Increase touch targets & revamp color swatches
    Improve touch usability and visual clarity across the UI. QuickPanel: refactor color swatch into an Item wrapper with a nested Rectangle for background/hover/active states, larger color dot, label, active check indicator, hover-enabled MouseArea and updated spacing/sizes. MissionPage: introduce readonly touchTarget and touchTargetLarge, enlarge map anchors/markers, fonts and POI visuals; increase slider, button, control and editor heights, spacing and radii to make controls more touch-friendly; adjust waypoint/POI delegate heights and interaction points. Also add two sticker image assets.
2026-04-15 Generalize case twin config beyond temperature metrics
2026-04-20 Added working light support on pico
2026-05-04 Support RP2350 FreeRTOS port and UI/LED fixes
    Switch CMake to the raspberrypi FreeRTOS-Kernel and integrate the RP2350_ARM_NTZ port; set PICO_BOARD to pico2_w and adjust project init to pull in the port before pico_sdk_init.
    Update FreeRTOSConfig.h for RP2350/Cortex-M33 (SMP, IRQ priorities, FPU/TrustZone options) and raise CPU clock to 150 MHz.
    Rework PIO / LED code and pins: move WS2811 to PIO1/GP3 at 800 kbps (ws2811.pio timing updated), adjust dma/pio channel indices, set initial diagnostic pixels; increase SK6812 worklight base and compute s_num_pixels to cover both regions.
    Improve display and UI: add ADC redraw hysteresis, partial redraw logic, fix key-locked logic, clear screen on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
    [MODBUSTester.c, gcs_tester.py, led_sk6812.c, led_sk6812.h, led_ws2811.c, pins.h, protocol.h, rs485.c]
2026-05-04 Add multi-MCU RS-485 peripheral slave framework
    Reusable slave-side library for the RS-485 peripheral bus, the
    counterpart to the existing master in GCS/src/rs485.c. Targets RP2040,
    STM32G031 and ESP32 from the same source tree via a small HAL split.
    Layout:
    - Framework/core portable C: framing FSM, CRC, dispatch, PING/PONG,
    STREAM scheduling, /INT — no MCU headers
    - Framework/hal one .c per MCU implementing the 8-function hal.h
    - Framework/cmake add_peripheral(NAME MCU SOURCES) dispatcher + per-MCU
    back-ends (Pico SDK / CMSIS+G0 device / ESP-IDF)
    Three example apps (Searchlight 0x01, PanTilt 0x03, LightBar 0x04) with
    portable main.c and per-MC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
2026-05-04 Switch peripheral framework primary MCU to STM32F103C8T6
    Replaces the STM32G031 port with an STM32F103C8T6 port that matches
    the KL-GCS-MODBUS03 PCB1 netlist (USART2 PA2/PA3, DE on PA1, /INT on
    PA4, WS2812 on PB0). HSI->PLL @ 64 MHz, no HSE crystal on the board.
    - New Framework/cmake/stm32f1.cmake (Cortex-M3, cmsis_device_f1).
    - New Framework/hal/hal_stm32f1.c implementing the 8-fn HAL.
    - board_stm32f1.c for PanTilt (TIM2 full-remap servos on PB10/PB11),
    Searchlight (TIM1_CH1N PWM on PB13 + ADC1_IN0 NTC on PA0), and
    LightBar (DWT cycle-counted WS2812 bit-bang on PB0).
    - TARGET_MCU now defaults to stm32f1 in all three apps.
    - stm32g0 backend, HAL, and doc references removed.
    Co-Authored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
    [board_stm32f1.c, hal_stm32f1.c]
2026-05-04 Select TARGET_MCU early; refactor peripheral init
    Load MCU backend/toolchain at framework include time by resolving TARGET_MCU (default stm32f1) so compiler toolchain variables are available before project(). Move per-MCU includes out of add_peripheral and enforce that added peripherals match the resolved TARGET_MCU, invoking per-MCU init via cmake_language(CALL).
    rp2040: run pico_sdk_import.cmake at include time (so toolchain is configured) and defer pico_sdk_init() until the per-target function (called if pico helper commands are missing), avoiding premature project-state calls. stm32f1: add linker defsym stubs for _init/_fini to work around arm-none-eabi-gcc 14.x newlib-nano changes. Add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
